weipengz/Precision_SMU/Front Panel.pdf

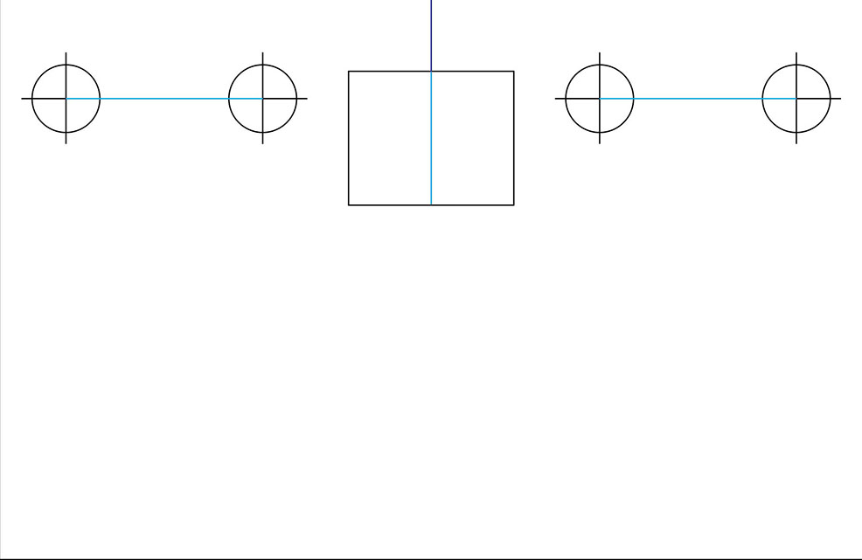
[picture p1: page 1]
