weipengz/Precision_SMU/smu_unit/BOM.xlsx

C1, C7, C8, C10, C11, C22 | 6 | ‎C0805X475J4RAC7800‎ | 0805 | 16V | 4.7uF
C2 | 1 | C1210C226K4RAC7800‎ | 1210 | 16V | 22uF
C3 | 4 | ‎C0805X475J4RAC7800 | 0805 | 16V | 4.7uF
C3, C6, C15, C19 | 4 | ‎CGA4J1X7R1H475K125AC‎‎ | 0805 | 50V | 4.7uF
C4, C5, C9, C13, C14, C16, C17, C21, C23, C30, C38, C39, C40, C42, C48, C57, C59 | 17 | C1210C106K5RACTU | 1210 | 50V | 10uF
C12, C32, C53, C60, C68 | 5 | ‎C0805C104J4RACTU‎ | 0805 | 16V | 0.1uF
C18, C29, C35, C37, C67 | 5 | ‎C0805C104J8RACTU‎ | 0805 | 10V | 0.1uF
C20, C27, C28 | 3 | C0603C102J4RACTU | 0603 | 16V | 1nF
C31, C52, C58, C61, C63 | 5 | C0603C104J5RAC7013 | 0603 | 50V | 0.1uF
C33, C36, C41, C43, C44, C49, C50, C51, C54, C55, C62, C64, C65 | 13 | C0603C104J4RACTU | 0603 | 16V | 0.1uF
C24 | 1 | C0603C224J4RACTU | 0603 | 16V | 0.22uF
C25, C47, C66 | 3 | C2012X7R0J106K125AB | 0805 | 6.3V | 10uF
C26 | 1 | C0805C475K8RACTU | 0805 | 10V | 4.7uF
C34 | 1 | A759PY687M1HAAE026 | thru hole | 50V | 680uF
C45, C46 | 2 | C1206C106J4RACTU | 1206 | 16V | 10uF
C56 | 1 | C0402C221F5GAC7867 | 0402 | 50V | 220pF
D1 | 1 | BAT46W-7-F | BAT46W-7-F
DS1, DS2 | 2 | TLMS1000-GS08 | TLMS1000-GS08
J1 | 1 | 61031421821 | 14pos double row
J2 | 1 | NPPC061KFXC-RC | 6pos single row
L1 | 1 | 750316743 | 750316743
L2, L5 | 2 | 744052470 | WE-TPC-5818-L
L3, L4 | 2 | 744043101 | WE-TPC-4828-MH
R1 | 1 | TNPW080533K2BEEN | 0805 | 33.2k
R2 | 1 | TNPW080554K9BEEN | 0805 | 54.9k
R3, R4 | 2 | TNPW0805150KBEEN | 0805 | 150k
R5, R7, R36, R38, R39, R41, R42, R43 | 8 | CRCW12060000Z0EA | 1206 | 0
R6, R18 | 2 | ‎RG3216P-2704-B-T1‎ | 1206 | 2.7M
R8, R17 | 2 | TNPW1206120KBEEA | 1206 | 120k
R9, R16, R37, R40 | 4 | TNPW0805100RBYEN | 0805 | 100
R10, R15 | 2 | TNPW1206100RBYEN | 1206 | 100
R11 | 1 | Y160610R0000D9W | RShunt | 10
R12, R13 | 2 | TNPW120610R0BEEA | 1206 | 10
R14, R21, R23, R26, R28, R31, R32 | 7 | TNPW0603100KBYEN | 0603 | 100k
R19, R22, R25, R27, R30, R33 | 6 | TNPW06031K00BYEN | 0603 | 1k
R20 | 1 | TNPW080513K7BEEN | 0805 | 13.7k
R24, R29 | 2 | TNPW08051K00BYEN | 0805 | 1k
R34 | 1 | TNPW060310K0BYEN | 0603 | 10k
R35 | 1 | TNPW120620R0BEEN | 1206 | 20
RN1 | 1 | LT5400ACMS8E-1#PBF | tssop8 | 10k
RN2 | 1 | LT5400BCMS8E-7#PBF | tssop8 | 1.25k/5k
SW1 | 1 | 09.03201.02 | EOZ-09.03201.02-3
TP1, TP2, TP3, TP4, TP5, TP6, TP7, TP8, TP9, TP10, TP12, TP13 | 12 | 5002 | KSTN-5002
TP11, TP14, TP15 | 3 | 5001 | KSTN-5001
U1, U2, U5 | 3 | LT3042IMSE#PBF | tssop
U3 | 1 | ADR4525CRZ-R7 | ADI-R-8_M
U4 | 1 | MAX11254ATJ+ | qfn
U6 | 1 | LT3093IMSE#PBF | tsop
U7 | 1 | ADA4528-1ARMZ-R7 | ADI-RM-8_M
U8 | 1 | SN74LVC1G19DRLR | DRL0006A_M
U9 | 1 | ADP1031ACPZ-1-R7 | CP_41_1
U10 | 1 | PGA281AIPWR | FP-PW0016A-IPC_A
U11 | 1 | AD5753BCPZ | cp_40_15-M | Purchased
U12 | 1 | ADA4522-2ARMZ | FP-RM-8-IPC_C
U13 | 1 | THP210DGKT | tsop
S1 | 1 | G-1750SA2500-0500YC
