weipengz/Precision_SMU/software/controllers/arduino/sketch_testv1/main/calibration/IMEBuild_v2_RevC_test_result.pptx

## Testing result for Imebuild v2 rev C

06/05/2020

## Schematic

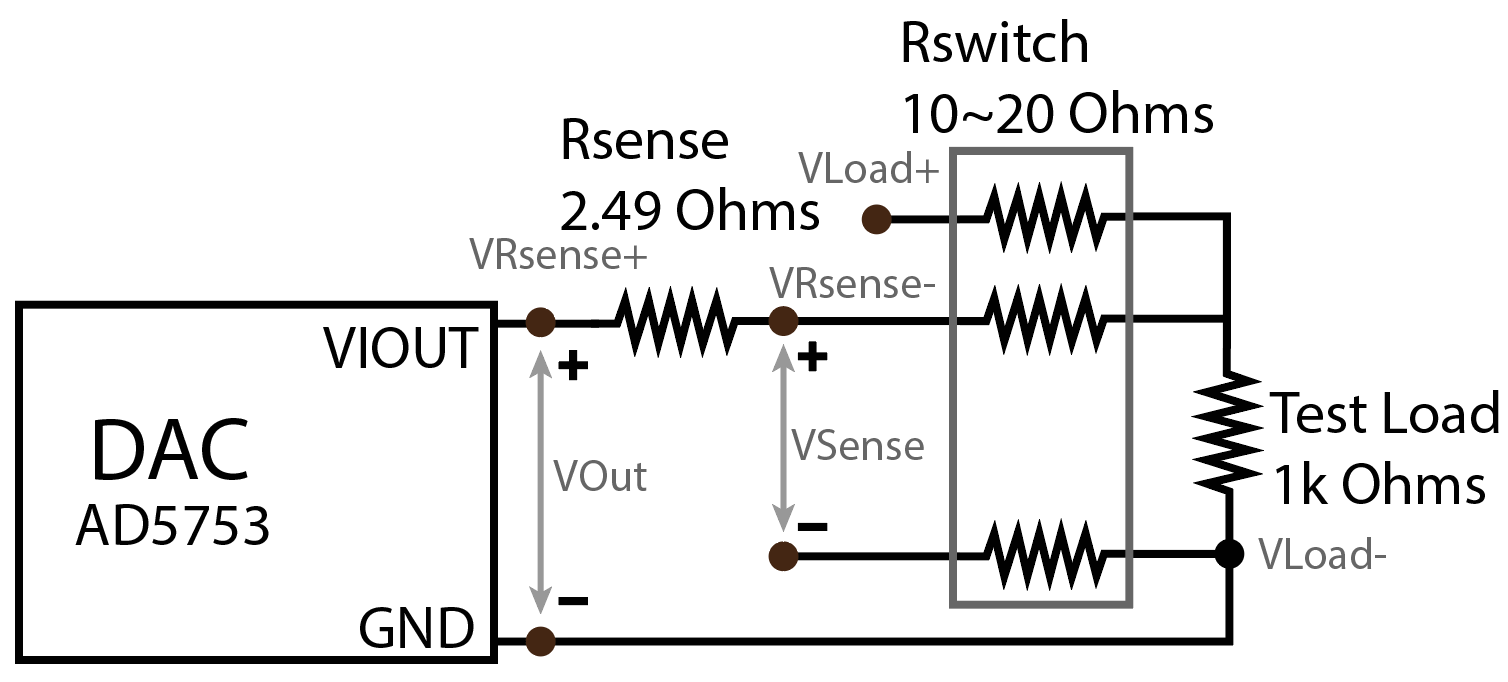
[picture p2: figure]

- R^2 : R-squared derived from linear fitting the measured results.
- Res (resolution):
Res=ln⁡((MSE(residual))/(Range))
- INL (integration nonlinearity):
INL=(max(abs(residual)))/(Range/max_dac_code)

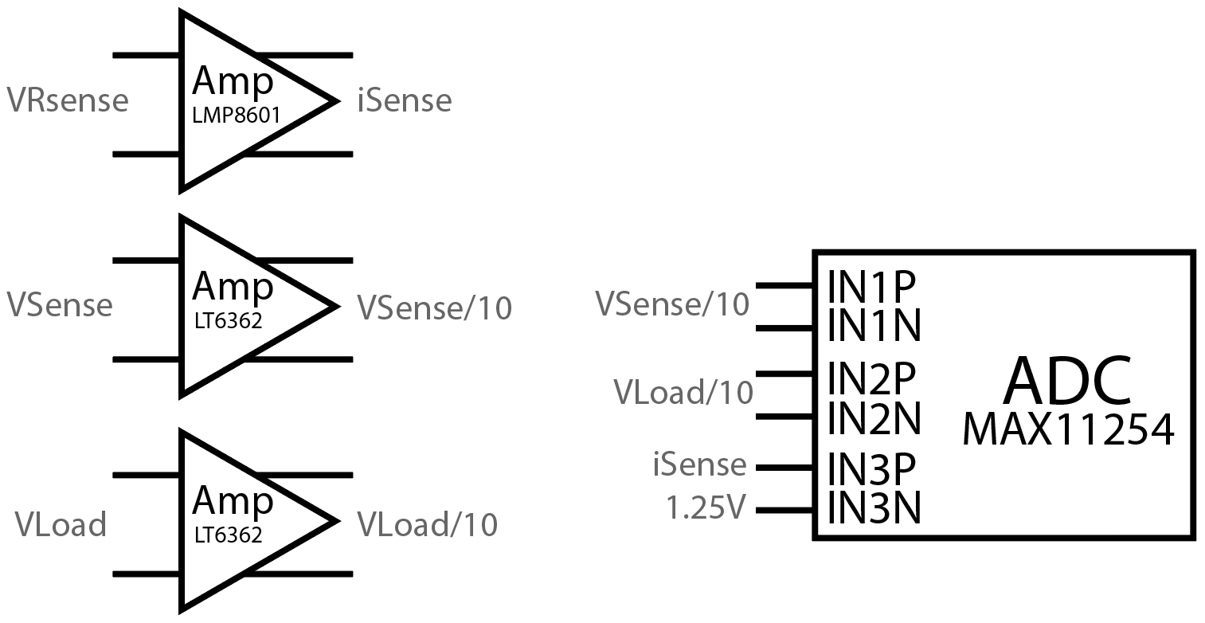
[picture p3: figure]

iSense=R_(sense) ×I_(Load) ×20+1.25V

## Ch 0

Unipolar

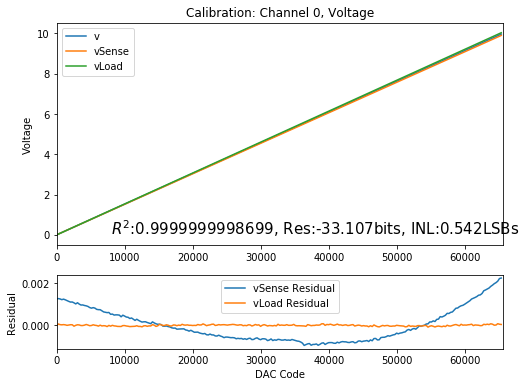
[picture p4: figure]
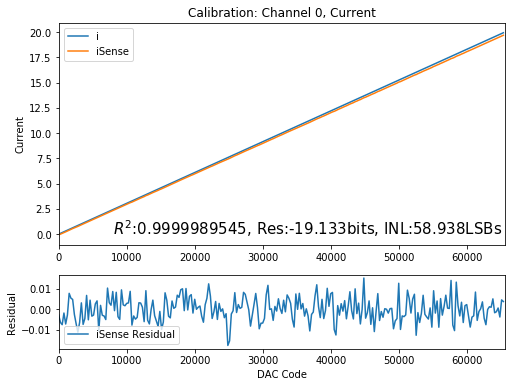
[picture p5: figure]

## Ch 1

Unipolar

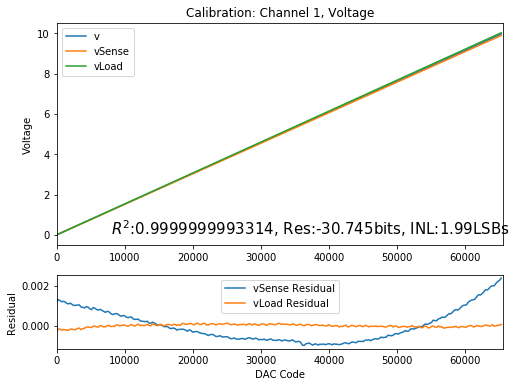
[picture p6: figure]
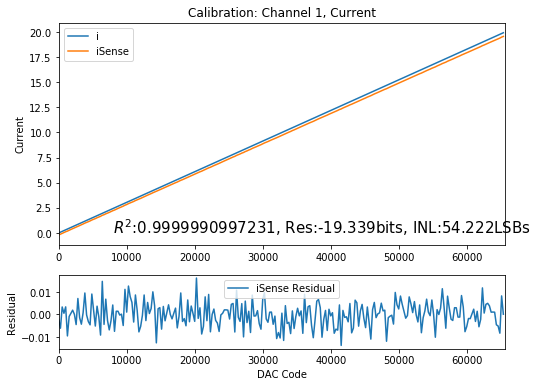
[picture p7: figure]

## Ch 2

Unipolar

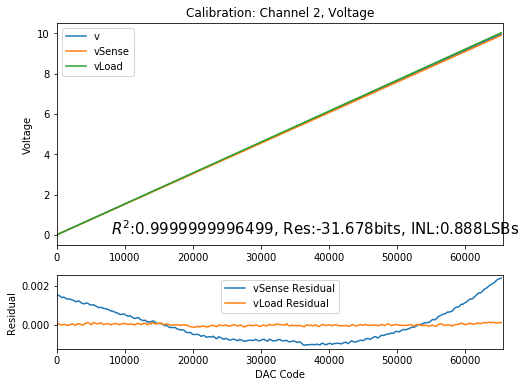
[picture p8: figure]
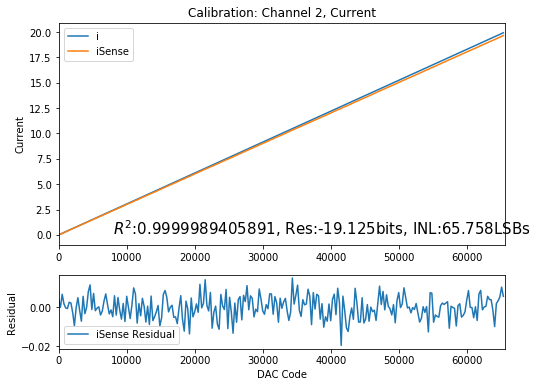
[picture p9: figure]

## Ch 3

Unipolar

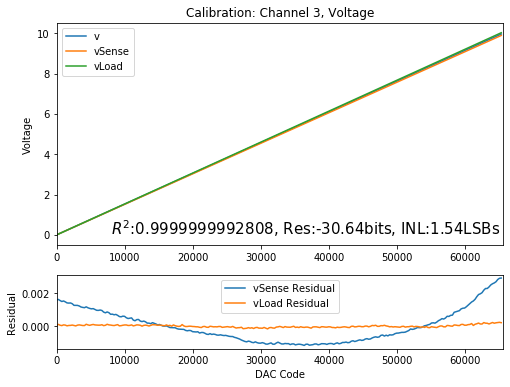
[picture p10: figure]
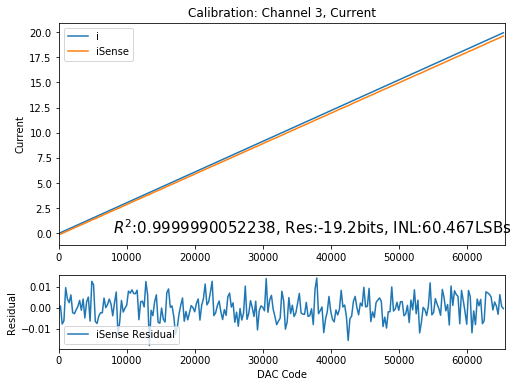
[picture p11: figure]

## Ch 4

Unipolar

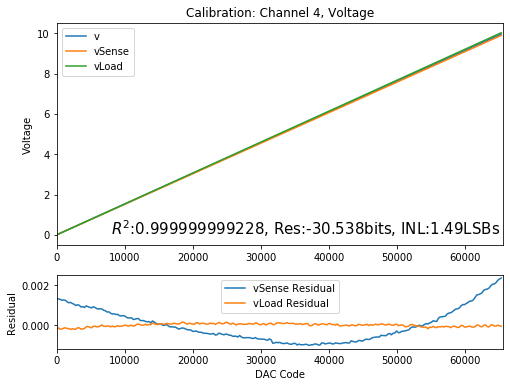
[picture p12: figure]
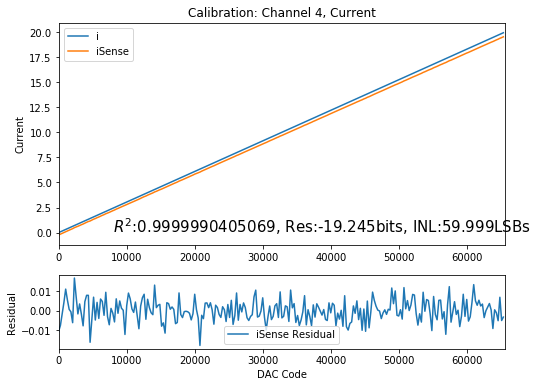
[picture p13: figure]

## Ch 5

Unipolar

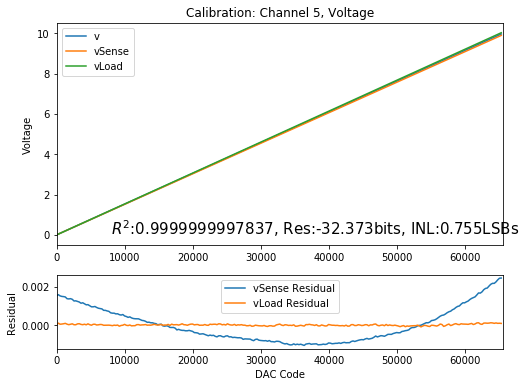
[picture p14: figure]
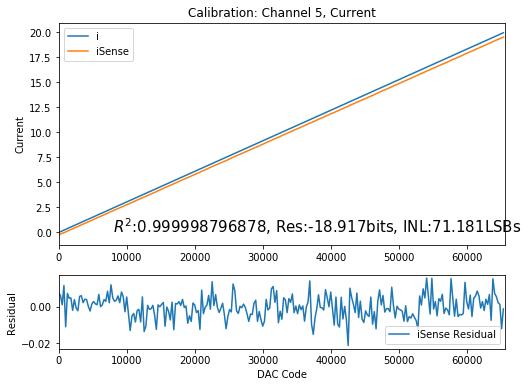
[picture p15: figure]

## Ch 6

Unipolar

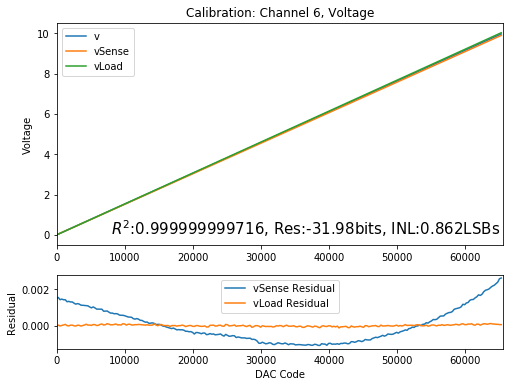
[picture p16: figure]
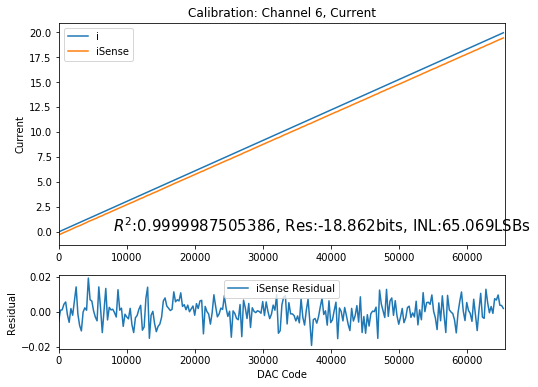
[picture p17: figure]

## Ch 7

Unipolar

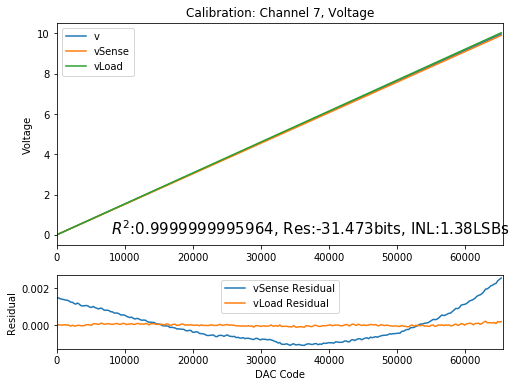
[picture p18: figure]
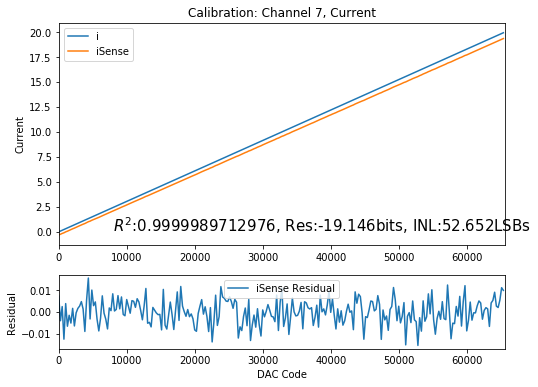
[picture p19: figure]

## Ch 0

Bipolar

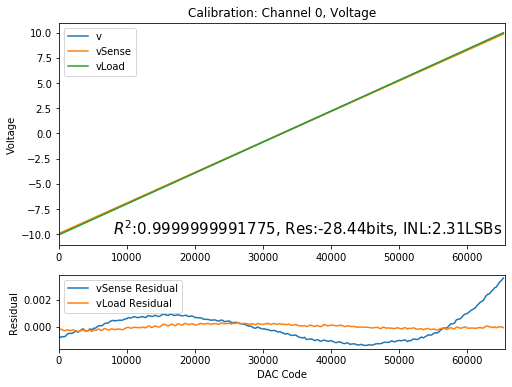
[picture p20: figure]
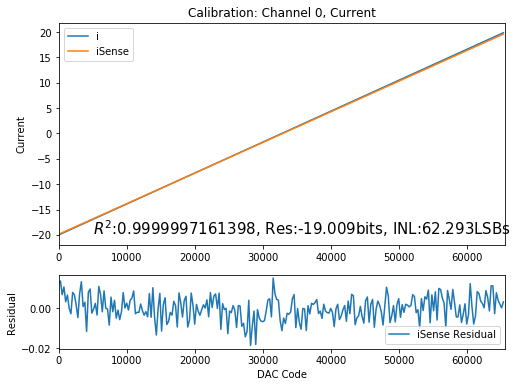
[picture p21: figure]

## Ch 1

Bipolar

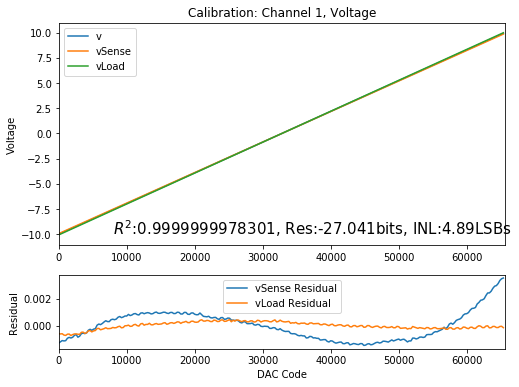
[picture p22: figure]
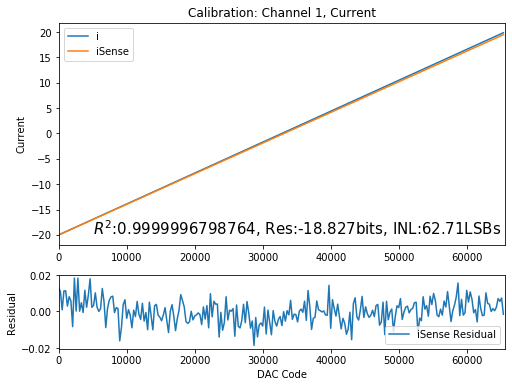
[picture p23: figure]

## Ch 2

Bipolar

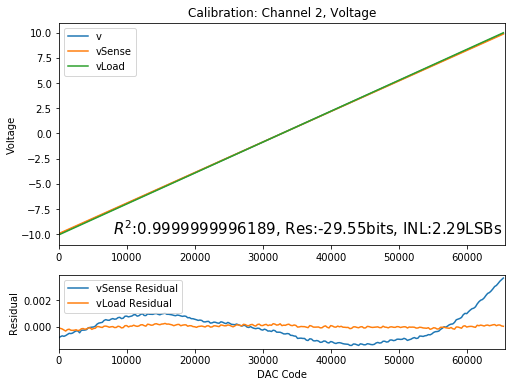
[picture p24: figure]
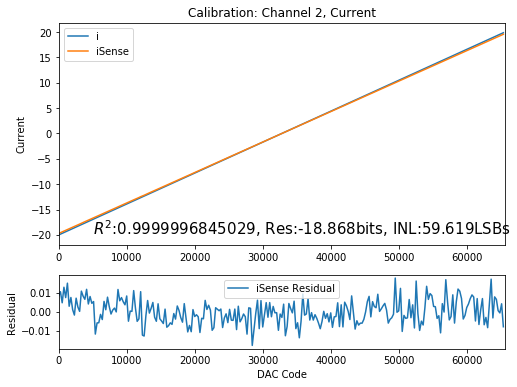
[picture p25: figure]

## Ch 3

Bipolar

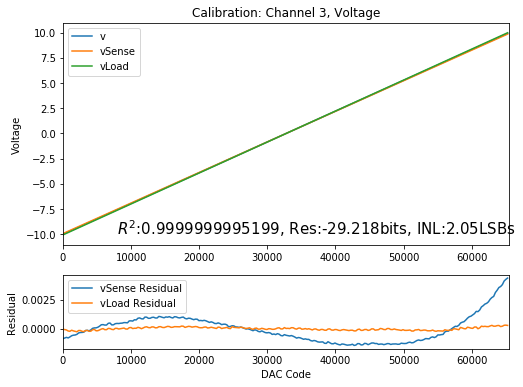
[picture p26: figure]
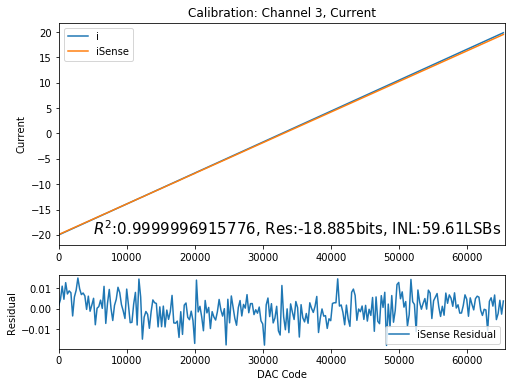
[picture p27: figure]

## Ch 4

Bipolar

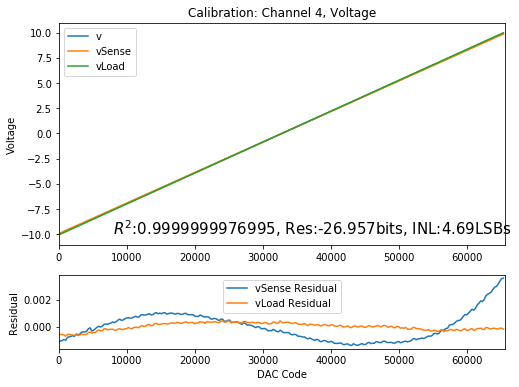
[picture p28: figure]
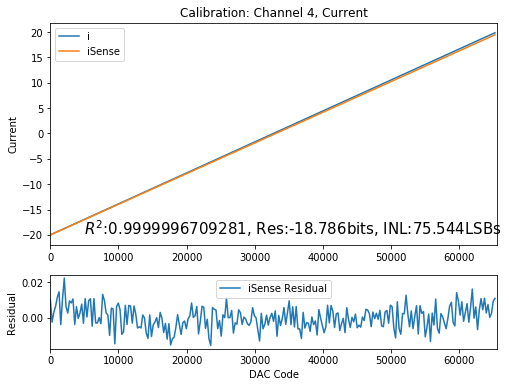
[picture p29: figure]

## Ch 5

Bipolar

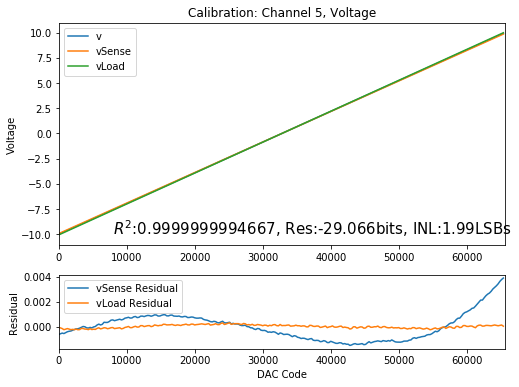
[picture p30: figure]
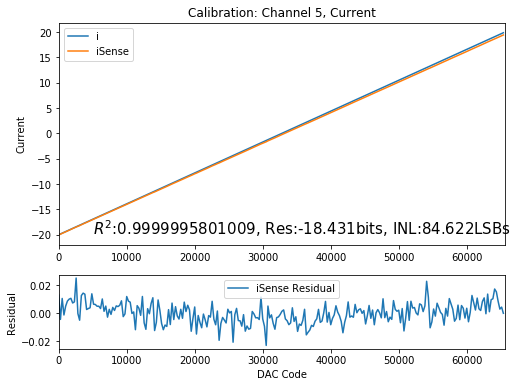
[picture p31: figure]

## Ch 6

Bipolar

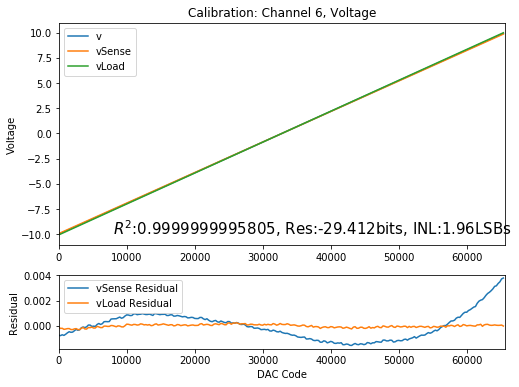
[picture p32: figure]
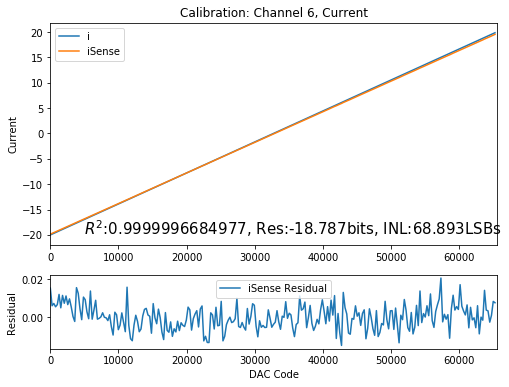
[picture p33: figure]

## Ch 7

Bipolar

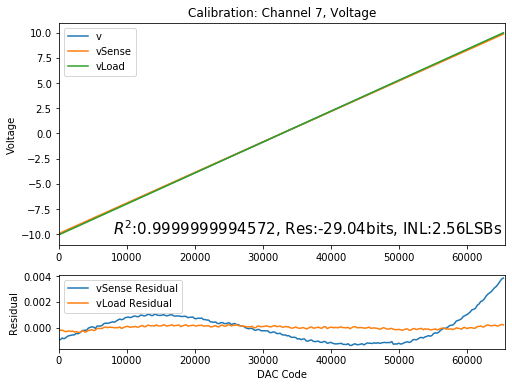
[picture p34: figure]
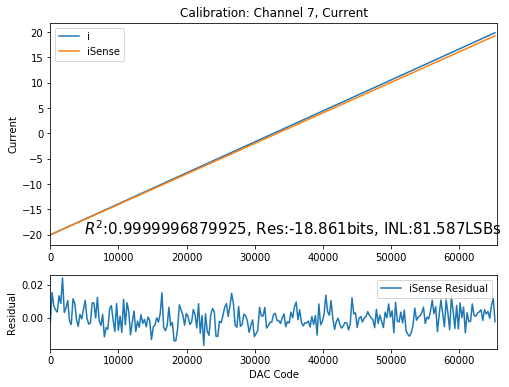
[picture p35: figure]
