weipengz/Precision_SMU/software/controllers/arduino/sketch_testv1/main/idc_adc1_plotted.xlsx

dac_code | adc1_code | adc1_code | adc1_code | adc1_code | adc1_code | adc1_code | adc1_code | adc1_code | adc1_code | adc1_code | adc1_avg_code | adc1_median_code | target_curr_ma | measured_curr_avg_ma |  | diff_curr_avg_ma | diff_curr_median_ma
0 | 2040 | 2053 | 2037 | 2043 | 2054 | 2040 | 2033 | 2039 | 2044 | 2040 | 2042.3 | 2040 | 0 | 0.06985951619 | 0.09804844378 | 0.06985951619 | 0.09804844378
16 | 2040 | 2037 | 2044 | 2035 | 2044 | 2050 | 2044 | 2031 | 2051 | 2047 | 2042.3 | 2044 | 0.0048828125 | 0.06985951619 | 0.04902422189 | 0.06497670369 | 0.04414140939
32 | 2052 | 2050 | 2032 | 2049 | 2051 | 2044 | 2045 | 2051 | 2047 | 2032 | 2045.3 | 2048 | 0.009765625 | 0.03309134977 | 0 | 0.02332572477 | -0.009765625
48 | 2043 | 2044 | 2036 | 2051 | 2038 | 2033 | 2043 | 2041 | 2044 | 2038 | 2041.1 | 2042 | 0.0146484375 | 0.08456678276 | 0.07353633283 | 0.06991834526 | 0.05888789533
64 | 2032 | 2051 | 2051 | 2037 | 2049 | 2051 | 2038 | 2051 | 2044 | 2036 | 2044 | 2046.5 | 0.01953125 | 0.04902422189 | 0.01838408321 | 0.02949297189 | -0.001147166792
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
