weipengz/Precision_SMU/software/controllers/arduino/sketch_sb/main/calibration/cal.xlsx

Sheet: CH2_V
dac_code | i_sense | v_sense | i_sense | v_sense | i_sense | v_sense | i_sense | v_sense | i_sense | v_sense | i_sense_avg | v_sense_avg | v_dac_code | v_convert
0 | 8335357 | 8388624 | 8333267 | 8388619 | 8335187 | 8388623 | 8333922 | 8388626 | 8336196 | 8388619 | 8334785.8 | 8388622.2 | 0 | 0.0003983723606
1024 | 8348401 | 8131494 | 8347818 | 8131486 | 8346354 | 8131525 | 8346455 | 8131498 | 8348385 | 8131502 | 8347482.6 | 8131501 | 0.0390625 | 0.03902495785
2048 | 8358795 | 7871529 | 8360848 | 7871527 | 8359937 | 7871519 | 8360178 | 7871543 | 8362318 | 7871525 | 8360415.2 | 7871528.6 | 0.078125 | 0.078079871
3072 | 8372646 | 7611539 | 8371373 | 7611513 | 8373726 | 7611529 | 8373299 | 7611504 | 8375012 | 7611497 | 8373211.2 | 7611516.4 | 0.1171875 | 0.1171407632
4096 | 8385791 | 7351534 | 8385846 | 7351550 | 8387052 | 7351533 | 8386249 | 7351540 | 8386372 | 7351537 | 8386262 | 7351538.8 | 0.15625 | 0.1561964575
5120 | 8399119 | 7091500 | 8399933 | 7091479 | 8398440 | 7091488 | 8398083 | 7091492 | 8399188 | 7091472 | 8398952.6 | 7091486.2 | 0.1953125 | 0.1952634189
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
