weipengz/Precision_SMU/software/controllers/arduino/sketch_testv1/main/calibration/calibrated/Slot8_Ch0_cal1.csv

dac_code | iSense | VSense | VLoad | iSense | VSense | VLoad | iSense | VSense | VLoad | iSense | VSense | VLoad | iSense | VSense | VLoad | iSense | VSense | VLoad | iSense | VSense | VLoad | iSense | VSense | VLoad | iSense | VSense | VLoad | iSense | VSense | VLoad
0 | 5982952 | 5032988 | 4988925 | 5982696 | 5032964 | 4988912 | 5983207 | 5032950 | 4988906 | 5982596 | 5032962 | 4988901 | 5981150 | 5032950 | 4988893 | 5981320 | 5032938 | 4988894 | 5981427 | 5032942 | 4988896 | 5982262 | 5032942 | 4988894 | 5980960 | 5032938 | 4988890 | 5981930 | 5032940 | 4988896
256 | 6001844 | 5059174 | 5015487 | 6000439 | 5059162 | 5015477 | 6000916 | 5059145 | 5015474 | 5999122 | 5059151 | 5015469 | 5999315 | 5059152 | 5015473 | 6000738 | 5059141 | 5015457 | 5999044 | 5059141 | 5015463 | 5998468 | 5059151 | 5015468 | 5998754 | 5059146 | 5015459 | 5999818 | 5059146 | 5015465
512 | 6017542 | 5085378 | 5042051 | 6019222 | 5085368 | 5042048 | 6017932 | 5085364 | 5042047 | 6018910 | 5085380 | 5042041 | 6016324 | 5085367 | 5042043 | 6019372 | 5085363 | 5042042 | 6016004 | 5085356 | 5042045 | 6018924 | 5085361 | 5042043 | 6017321 | 5085375 | 5042032 | 6017443 | 5085366 | 5042035
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
