weipengz/Precision_SMU/software/controllers/arduino/sketch_testv1/main/calibration/calibrated/Slot8_Ch0_cal2.csv

dac_code | iSense | VSense | VLoad | iSense | VSense | VLoad | iSense | VSense | VLoad | iSense | VSense | VLoad | iSense | VSense | VLoad | iSense | VSense | VLoad | iSense | VSense | VLoad | iSense | VSense | VLoad | iSense | VSense | VLoad | iSense | VSense | VLoad
0 | 5048105 | 3688448 | 3624178 | 5047642 | 3688474 | 3624175 | 5045823 | 3688456 | 3624170 | 5048131 | 3688510 | 3624179 | 5047470 | 3688494 | 3624179 | 5046146 | 3688496 | 3624184 | 5047778 | 3688494 | 3624183 | 5047794 | 3688524 | 3624182 | 5048337 | 3688500 | 3624168 | 5046845 | 3688518 | 3624189
256 | 5074506 | 3725988 | 3662283 | 5073762 | 3726002 | 3662290 | 5073962 | 3726012 | 3662302 | 5072626 | 3725996 | 3662277 | 5074084 | 3726009 | 3662302 | 5073884 | 3726034 | 3662299 | 5073388 | 3726028 | 3662288 | 5073780 | 3726016 | 3662304 | 5072208 | 3726045 | 3662300 | 5072168 | 3726018 | 3662296
512 | 5100750 | 3763525 | 3700431 | 5101971 | 3763550 | 3700421 | 5098824 | 3763518 | 3700432 | 5098752 | 3763533 | 3700401 | 5098224 | 3763552 | 3700400 | 5100040 | 3763551 | 3700423 | 5099242 | 3763534 | 3700391 | 5099018 | 3763554 | 3700421 | 5100499 | 3763533 | 3700412 | 5099770 | 3763551 | 3700417
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
