weipengz/Precision_SMU/software/controllers/arduino/sketch_testv1/main/calibration/calibrated/Slot8_Ch2_cal1.csv

dac_code | iSense | VSense | VLoad | iSense | VSense | VLoad | iSense | VSense | VLoad | iSense | VSense | VLoad | iSense | VSense | VLoad | iSense | VSense | VLoad | iSense | VSense | VLoad | iSense | VSense | VLoad | iSense | VSense | VLoad | iSense | VSense | VLoad
0 | 5985426 | 5033062 | 4988228 | 5982392 | 5033032 | 4988204 | 5982373 | 5033032 | 4988208 | 5985648 | 5033026 | 4988208 | 5983348 | 5033028 | 4988208 | 5983623 | 5033028 | 4988216 | 5983986 | 5033026 | 4988188 | 5982193 | 5033022 | 4988182 | 5983266 | 5033024 | 4988196 | 5983944 | 5033022 | 4988179
256 | 6000385 | 5059262 | 5014796 | 6000554 | 5059252 | 5014804 | 5999043 | 5059238 | 5014797 | 6000840 | 5059244 | 5014794 | 6001003 | 5059238 | 5014784 | 5999956 | 5059246 | 5014783 | 6000676 | 5059248 | 5014793 | 5999478 | 5059244 | 5014786 | 6000587 | 5059240 | 5014770 | 6001091 | 5059240 | 5014779
512 | 6018947 | 5085474 | 5041367 | 6019805 | 5085461 | 5041379 | 6020395 | 5085468 | 5041378 | 6018517 | 5085460 | 5041367 | 6018239 | 5085459 | 5041363 | 6021010 | 5085464 | 5041366 | 6020310 | 5085460 | 5041361 | 6019954 | 5085448 | 5041348 | 6019522 | 5085450 | 5041354 | 6018431 | 5085442 | 5041357
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
