weipengz/Precision_SMU/software/controllers/arduino/sketch_testv1/main/calibration/calibrated/Slot8_Ch2_cal2.csv

dac_code | iSense | VSense | VLoad | iSense | VSense | VLoad | iSense | VSense | VLoad | iSense | VSense | VLoad | iSense | VSense | VLoad | iSense | VSense | VLoad | iSense | VSense | VLoad | iSense | VSense | VLoad | iSense | VSense | VLoad | iSense | VSense | VLoad
0 | 5047155 | 3687510 | 3621857 | 5047948 | 3687551 | 3621870 | 5048552 | 3687542 | 3621863 | 5046714 | 3687581 | 3621864 | 5049907 | 3687578 | 3621879 | 5045485 | 3687598 | 3621884 | 5047054 | 3687582 | 3621908 | 5050182 | 3687580 | 3621894 | 5047606 | 3687589 | 3621894 | 5047738 | 3687584 | 3621912
256 | 5074760 | 3725062 | 3659986 | 5072258 | 3725046 | 3659960 | 5073426 | 3725080 | 3659997 | 5071723 | 3725088 | 3659991 | 5073628 | 3725062 | 3660004 | 5073632 | 3725074 | 3659976 | 5072737 | 3725073 | 3660002 | 5073788 | 3725069 | 3659980 | 5074536 | 3725094 | 3660019 | 5075527 | 3725098 | 3660021
512 | 5099336 | 3762622 | 3698145 | 5101116 | 3762610 | 3698138 | 5099134 | 3762625 | 3698128 | 5097886 | 3762621 | 3698136 | 5098679 | 3762608 | 3698132 | 5099436 | 3762607 | 3698134 | 5099768 | 3762608 | 3698154 | 5099462 | 3762629 | 3698125 | 5099171 | 3762619 | 3698144 | 5099834 | 3762613 | 3698121
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
