weipengz/Precision_SMU/software/controllers/arduino/sketch_testv1/main/calibration/calibrated/Slot8_Ch3_cal1.csv

dac_code | iSense | VSense | VLoad | iSense | VSense | VLoad | iSense | VSense | VLoad | iSense | VSense | VLoad | iSense | VSense | VLoad | iSense | VSense | VLoad | iSense | VSense | VLoad | iSense | VSense | VLoad | iSense | VSense | VLoad | iSense | VSense | VLoad
0 | 5983235 | 5033144 | 4988428 | 5984329 | 5033116 | 4988414 | 5983109 | 5033110 | 4988390 | 5983910 | 5033095 | 4988398 | 5982586 | 5033091 | 4988400 | 5984884 | 5033091 | 4988384 | 5984236 | 5033101 | 4988390 | 5983288 | 5033093 | 4988390 | 5983924 | 5033087 | 4988381 | 5982473 | 5033092 | 4988388
256 | 6002123 | 5059309 | 5014972 | 6001152 | 5059301 | 5014964 | 6001314 | 5059305 | 5014966 | 6001018 | 5059303 | 5014954 | 6001068 | 5059300 | 5014952 | 6000286 | 5059300 | 5014944 | 6000306 | 5059296 | 5014950 | 6000977 | 5059306 | 5014950 | 6001140 | 5059296 | 5014950 | 6002464 | 5059303 | 5014958
512 | 6019824 | 5085528 | 5041543 | 6021334 | 5085526 | 5041547 | 6019647 | 5085518 | 5041557 | 6018796 | 5085518 | 5041536 | 6019647 | 5085514 | 5041516 | 6019009 | 5085522 | 5041539 | 6017604 | 5085506 | 5041528 | 6021042 | 5085512 | 5041526 | 6019830 | 5085520 | 5041526 | 6020516 | 5085502 | 5041522
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
