weipengz/Precision_SMU/software/controllers/arduino/sketch_testv1/main/calibration/calibrated/Slot8_Ch3_cal2.csv

dac_code | iSense | VSense | VLoad | iSense | VSense | VLoad | iSense | VSense | VLoad | iSense | VSense | VLoad | iSense | VSense | VLoad | iSense | VSense | VLoad | iSense | VSense | VLoad | iSense | VSense | VLoad | iSense | VSense | VLoad | iSense | VSense | VLoad
0 | 5049014 | 3687911 | 3622436 | 5047710 | 3687915 | 3622454 | 5046767 | 3687933 | 3622486 | 5048766 | 3687961 | 3622460 | 5047360 | 3687972 | 3622481 | 5047339 | 3687947 | 3622483 | 5048724 | 3687976 | 3622462 | 5049232 | 3687956 | 3622490 | 5049619 | 3687978 | 3622504 | 5049984 | 3687968 | 3622492
256 | 5072849 | 3725534 | 3660663 | 5072720 | 3725538 | 3660683 | 5075338 | 3725542 | 3660697 | 5074434 | 3725540 | 3660701 | 5074193 | 3725558 | 3660707 | 5073644 | 3725567 | 3660692 | 5074009 | 3725564 | 3660711 | 5073187 | 3725578 | 3660672 | 5073307 | 3725567 | 3660675 | 5072764 | 3725554 | 3660681
512 | 5099343 | 3763078 | 3698790 | 5100183 | 3763090 | 3698808 | 5098852 | 3763088 | 3698849 | 5099145 | 3763099 | 3698830 | 5099574 | 3763111 | 3698856 | 5103692 | 3763115 | 3698856 | 5100286 | 3763086 | 3698846 | 5101496 | 3763109 | 3698818 | 5099062 | 3763115 | 3698829 | 5099000 | 3763106 | 3698842
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
