weipengz/Precision_SMU/documents/reading/750316743.pdf

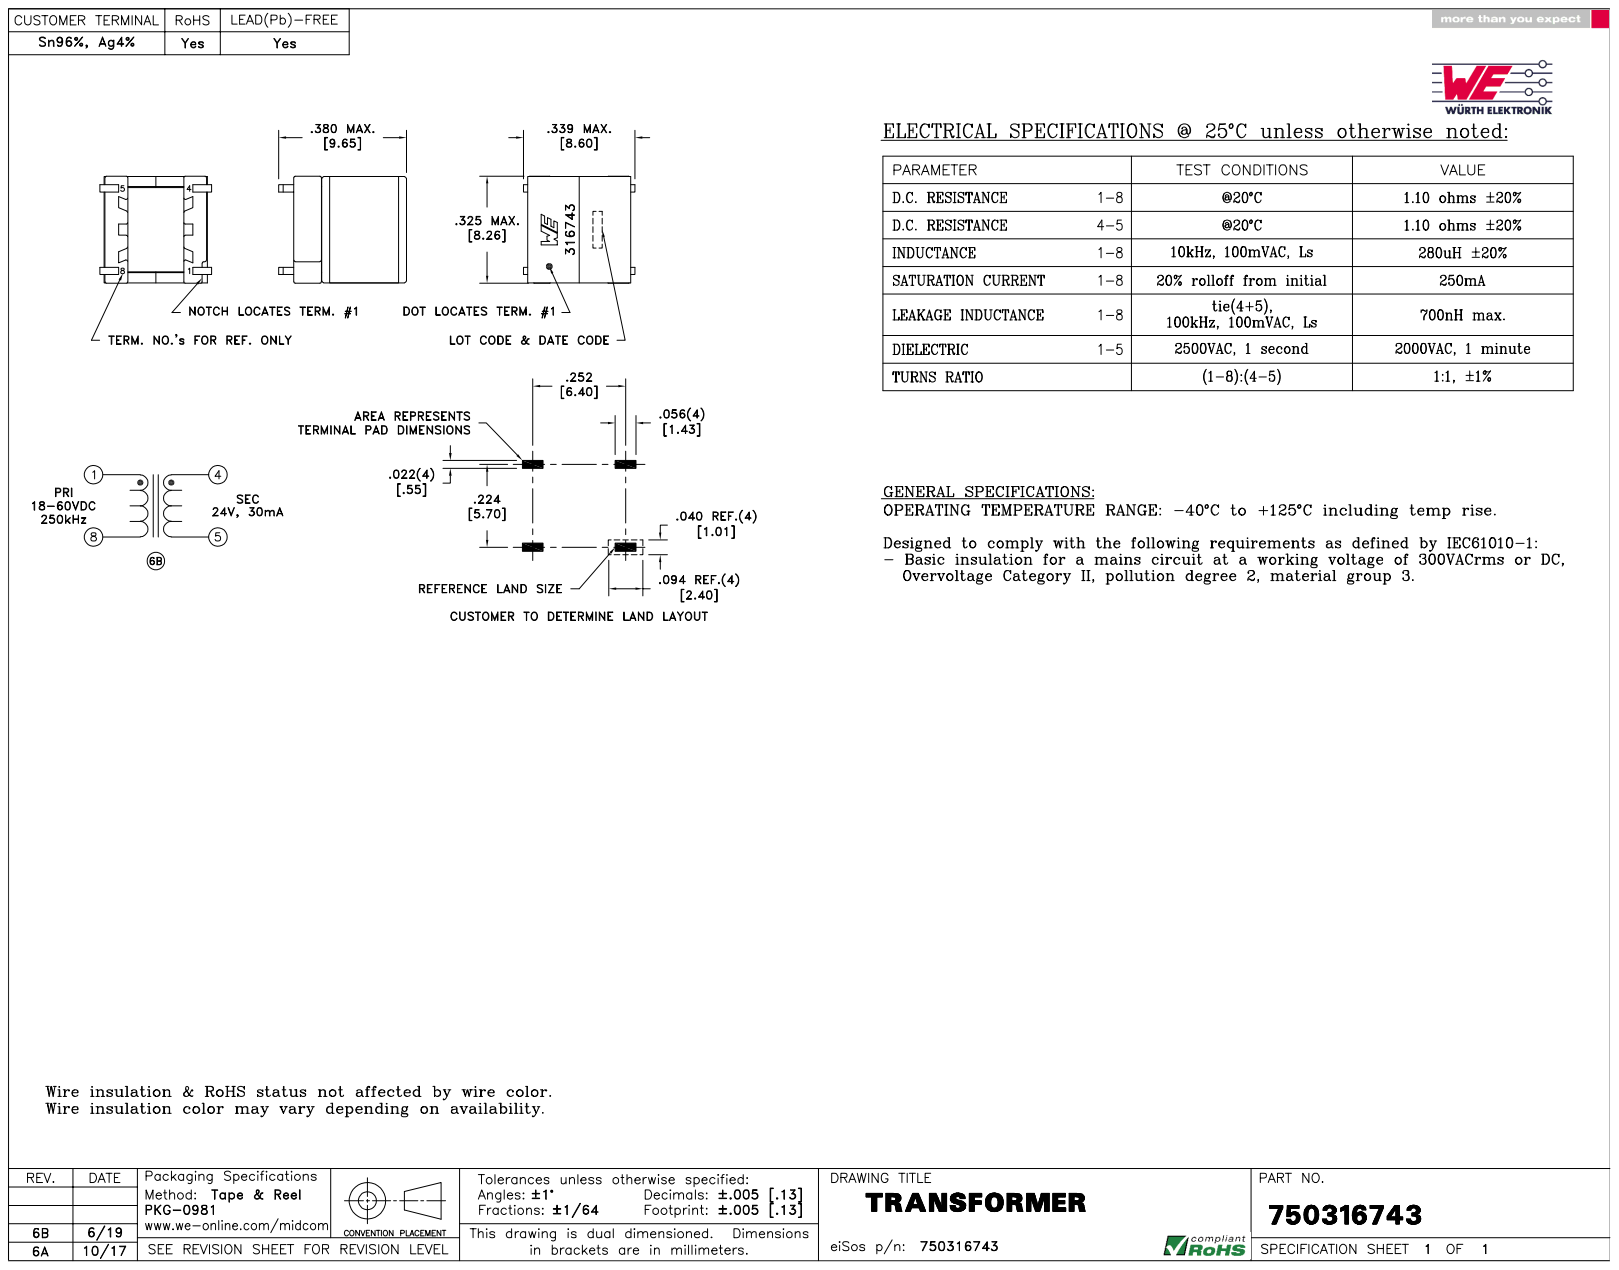
[picture p36: page 1]
