weipengz/Precision_SMU/documents/reading/dr-ccs-john-108-0904-001.pdf

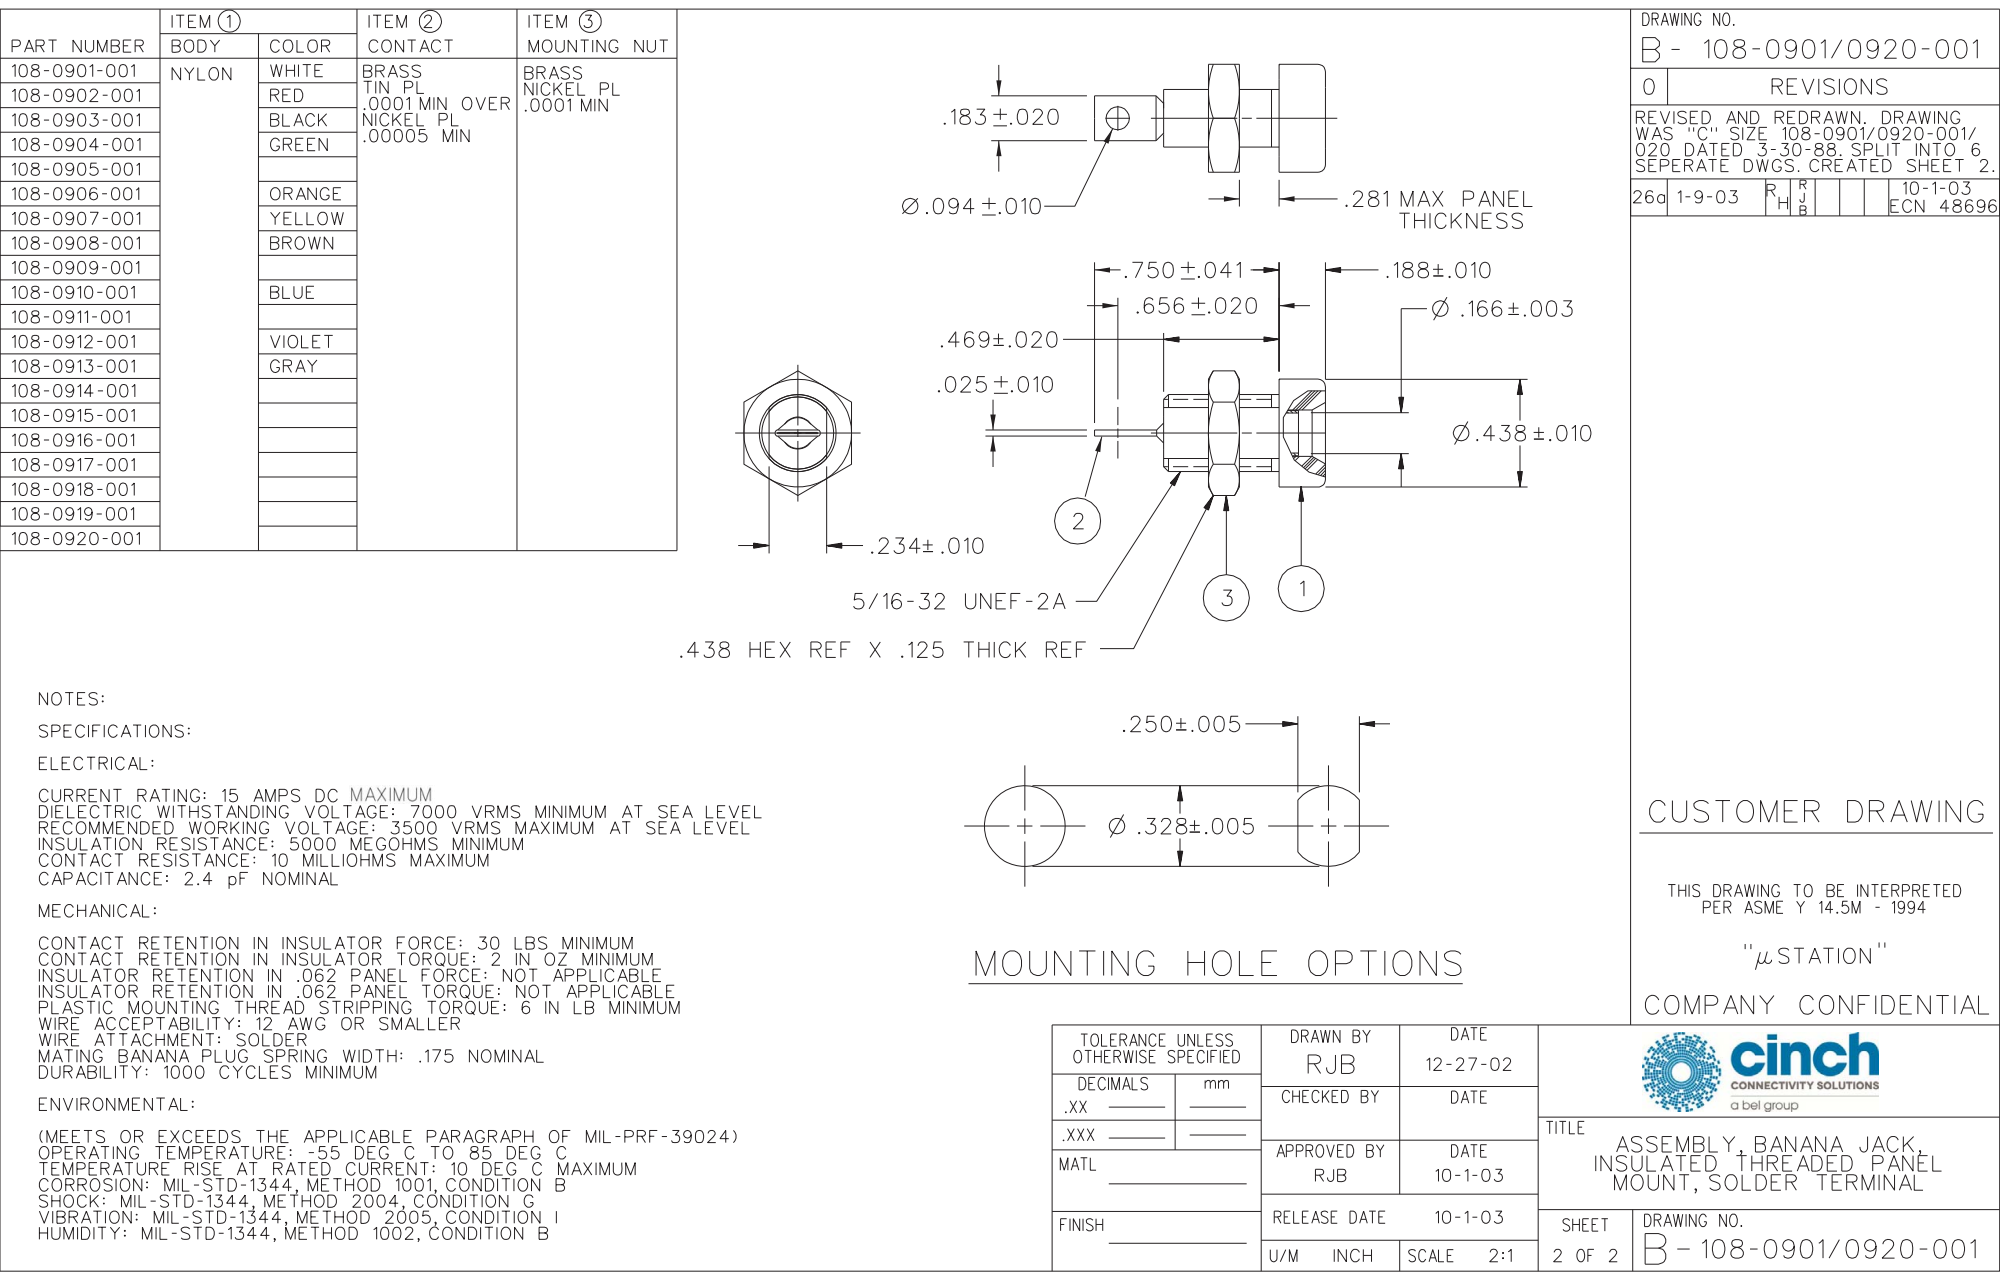
[picture p37: page 1]
