weipengz/Precision_SMU/documents/reading/ENG_CD_146252_G2.pdf

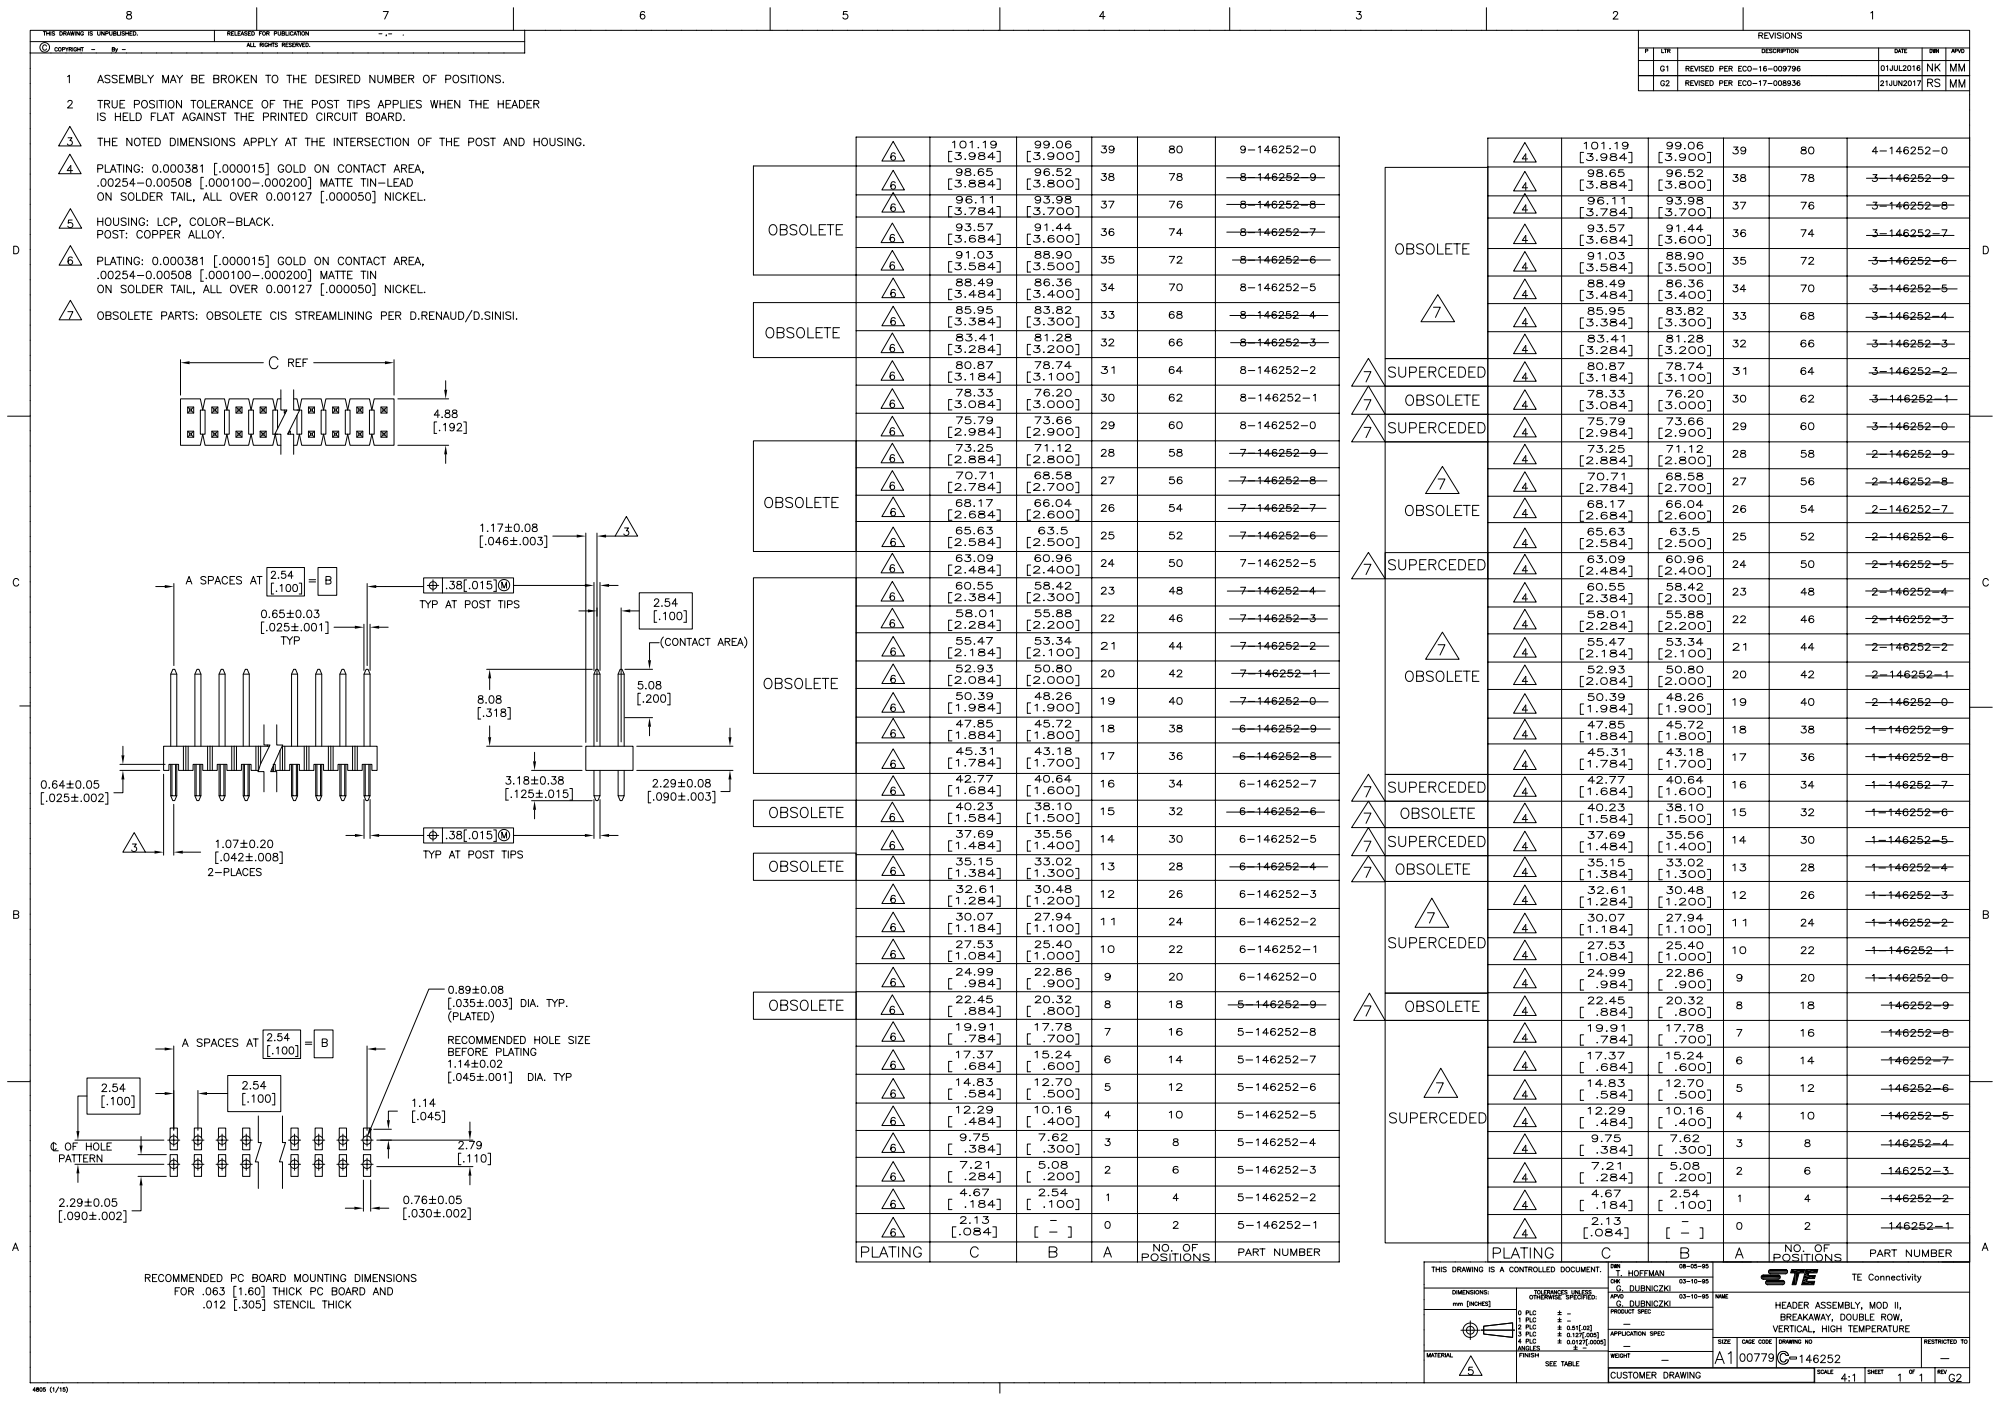
[picture p38: page 1]
