weipengz/Precision_SMU/(list of files, drawings)

Other design files:
motherboard_2ch_arduino/Archive/RevA/motherboard_2ch_arduino.PcbDoc
motherboard_2ch_arduino/Archive/RevA/motherboard_2ch_arduino.PrjPcb
motherboard_2ch_arduino/Archive/RevA/motherboard_2ch_arduino.SchDoc
motherboard_2ch_arduino/Header.PcbLib
motherboard_2ch_arduino/Header.SchLib
motherboard_2ch_arduino/manual.PcbLib
motherboard_2ch_arduino/manual.SchLib
motherboard_2ch_arduino/motherboard_2ch_arduino.PcbDoc
motherboard_2ch_arduino/motherboard_2ch_arduino.PrjPcb
motherboard_2ch_arduino/motherboard_2ch_arduino.SchDoc
smu_unit/Archive/RevA/smu_unit.PrjPcb
smu_unit/Archive/RevA/smu_unit.SchDoc
smu_unit/smu_unit.PrjPcb
smu_unit/smu_unit.SchDoc
