weipengz/Precision_SMU/software/controllers/arduino/sketch_testv1/main/ArduinoYun2Controller.h

/*
ArduinoYun2Controller.h - Pinout for the Yun2 Shield (Backplane REV A)
Copyright (c) 2019 Lightwave Lab, Princeton University
*/

#ifndef ARD_YUN2_CONT_h
#define ARD_YUN2_CONT_h

#include <Arduino.h>

#define BSENABLE_N      11
#define CS0             2
#define CS1             3
#define CS2             4
#define CS3             10
#define DADCS           9
#define FAULTOUT        A1
#define MONITORCS_N     12
#define MONITORRST_N    13
#define POWEROUT        A0
#define SELECT0         5
#define SELECT1         6
#define SELECT2         7
#define SELECT3         8

#endif
