weipengz/Precision_SMU/software/controllers/raspberryPi/controller.h

/*
controller.h - Global configuration variables
Copyright (c) 2020 Lightwave Lab, Princeton University
*/

#ifndef CONTROLLER_h
#define CONTROLLER_h

#include "globals.h"

exit_code controller_setup(void);
//~ void controller_close(void);
#endif
